tolgacatak17/PinballMachine/figures/Mechanical Design/Bumper.png

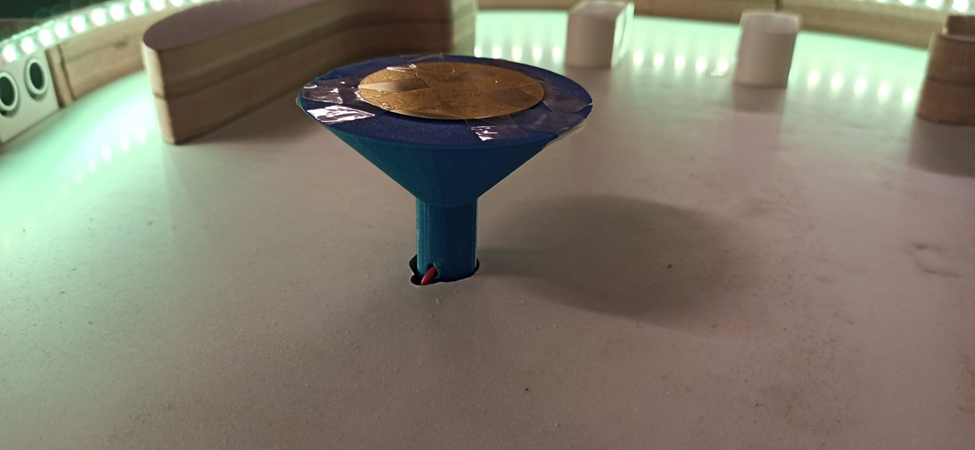
figures/Mechanical Design/Bumper.png
