tolgacatak17/PinballMachine/figures/Mechanical Design/Spinner CAD.png

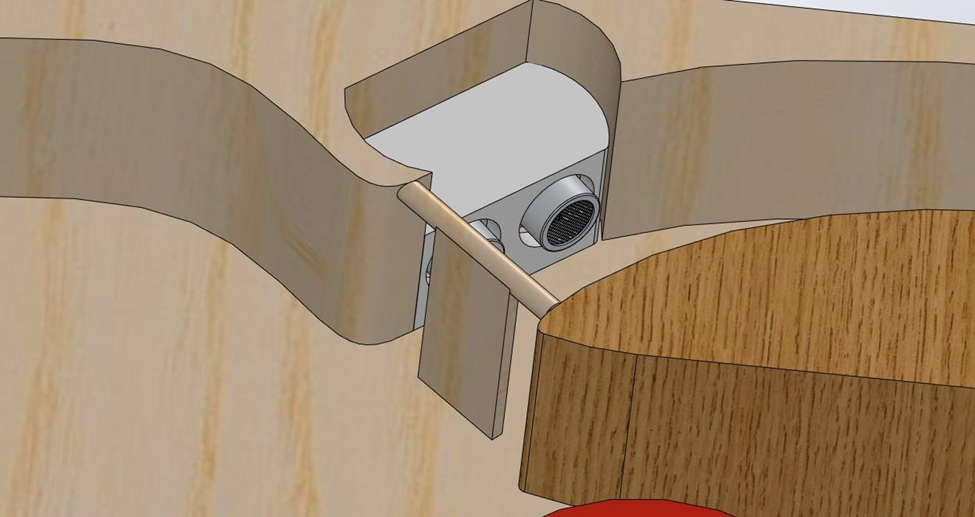
figures/Mechanical Design/Spinner CAD.png
