tolgacatak17/PinballMachine/figures/Electrical Design/Bumper Circuit Diagram.png

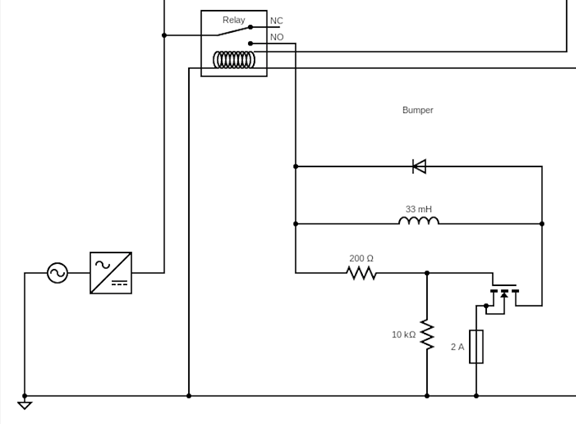
figures/Electrical Design/Bumper Circuit Diagram.png
