tolgacatak17/PinballMachine/figures/Electrical Design/In-Game Pusher Sensor.png

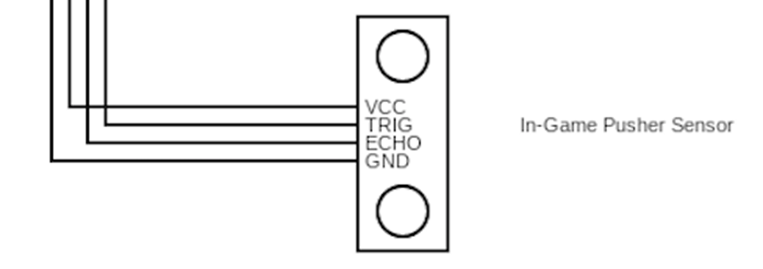
figures/Electrical Design/In-Game Pusher Sensor.png
