tolgacatak17/PinballMachine/figures/Electrical Design/In-Game Shooter Circuit Diagram.png

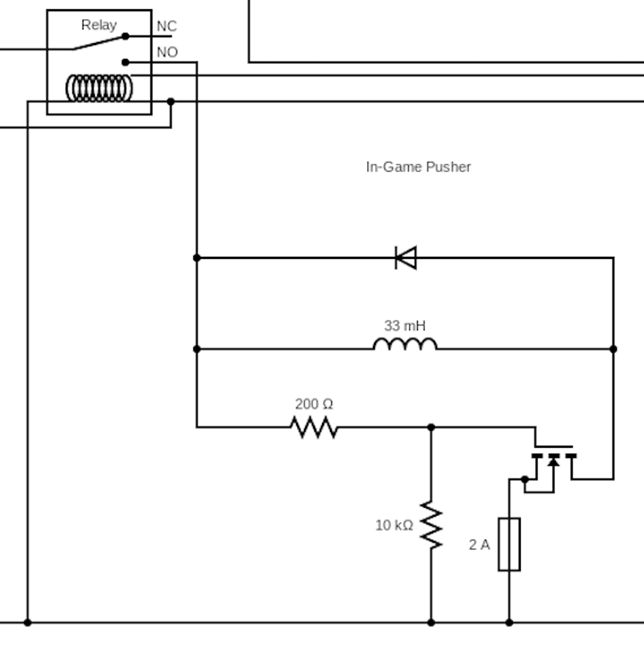
figures/Electrical Design/In-Game Shooter Circuit Diagram.png
