tolgacatak17/PinballMachine/figures/Electrical Design/Life Counting Sensor Diagram.png

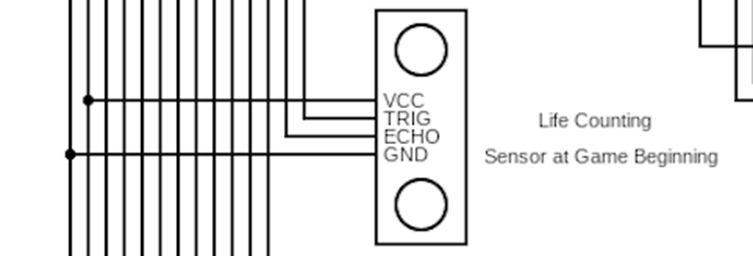
figures/Electrical Design/Life Counting Sensor Diagram.png
