tolgacatak17/PinballMachine/figures/Electrical Design/Piezo Sensor Circuit Diagram.png

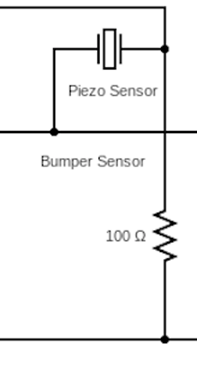
figures/Electrical Design/Piezo Sensor Circuit Diagram.png
