tolgacatak17/PinballMachine/figures/Electrical Design/RGB LEDs Circuit Diagram.png

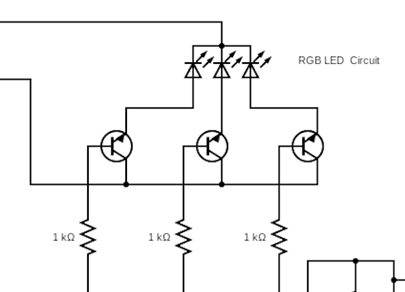
figures/Electrical Design/RGB LEDs Circuit Diagram.png
