tolgacatak17/PinballMachine/figures/Electrical Design/Spinner Circuit Diagram.png

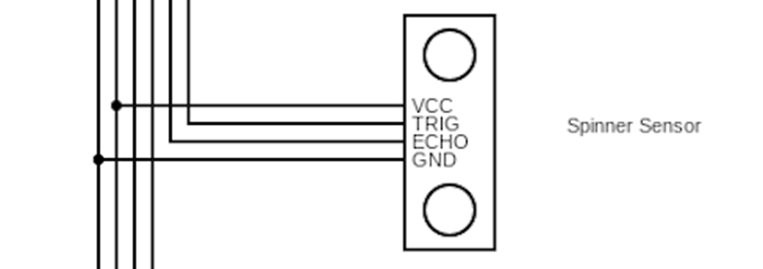
figures/Electrical Design/Spinner Circuit Diagram.png
