tolgacatak17/PinballMachine/figures/Market Analysis.png

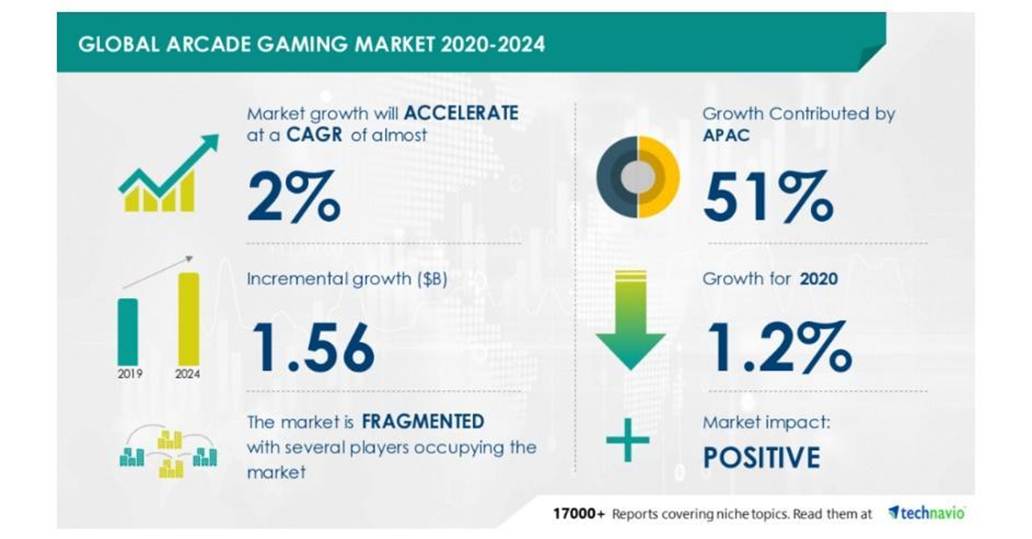
figures/Market Analysis.png
