tolgacatak17/PinballMachine/figures/Mechanical Design/Bumper CAD.png

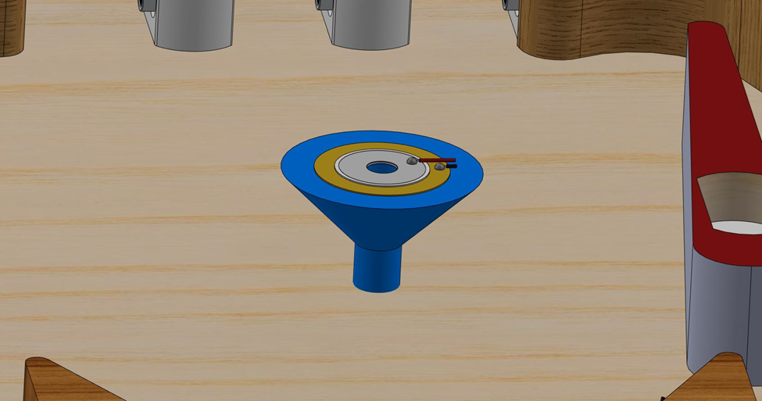
figures/Mechanical Design/Bumper CAD.png
