tolgacatak17/PinballMachine/figures/Mechanical Design/In-Game Shooter CAD.png

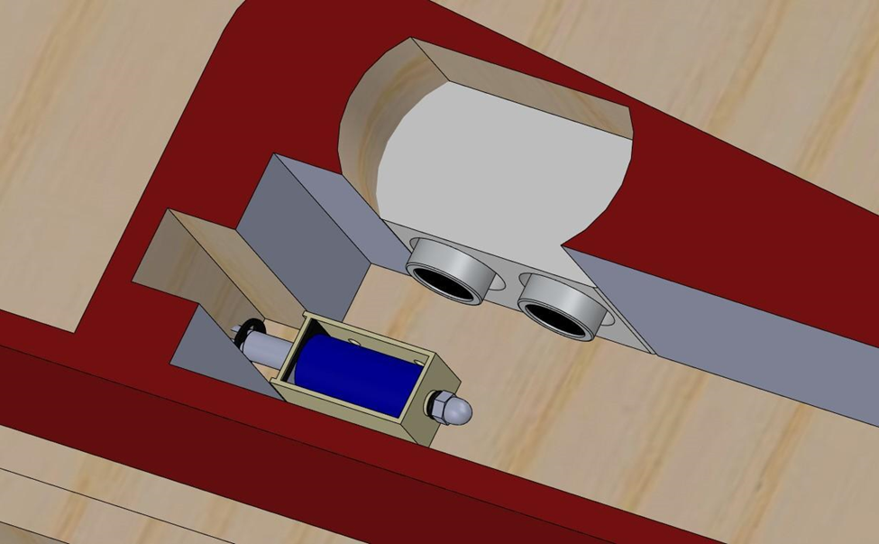
figures/Mechanical Design/In-Game Shooter CAD.png
