tolgacatak17/PinballMachine/figures/Mechanical Design/In-Game Shooter.png

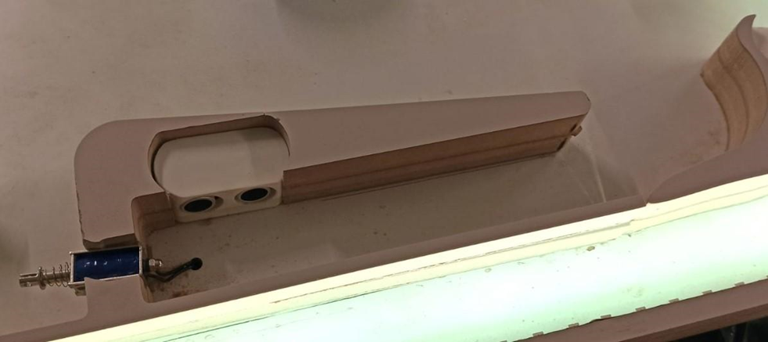
figures/Mechanical Design/In-Game Shooter.png
