tolgacatak17/PinballMachine/figures/Mechanical Design/LCD Screen.png

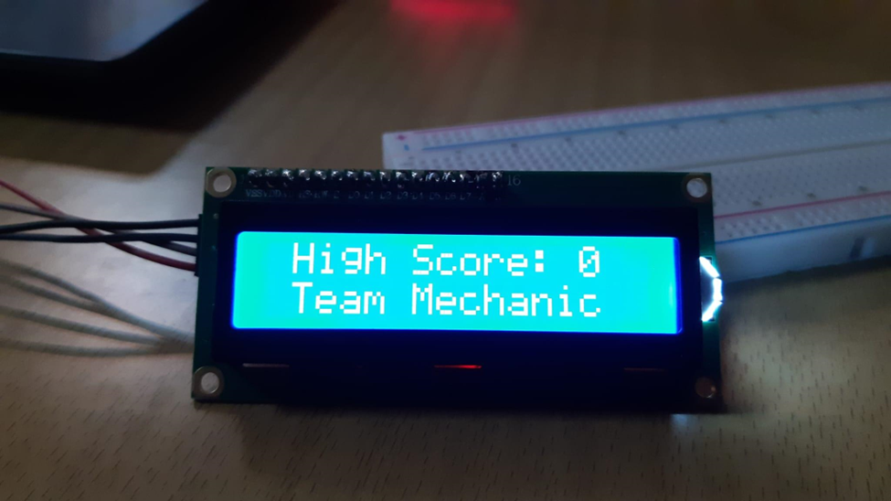
figures/Mechanical Design/LCD Screen.png
