tolgacatak17/PinballMachine/figures/Mechanical Design/Mechanism for the Bumper with Selonoid.png

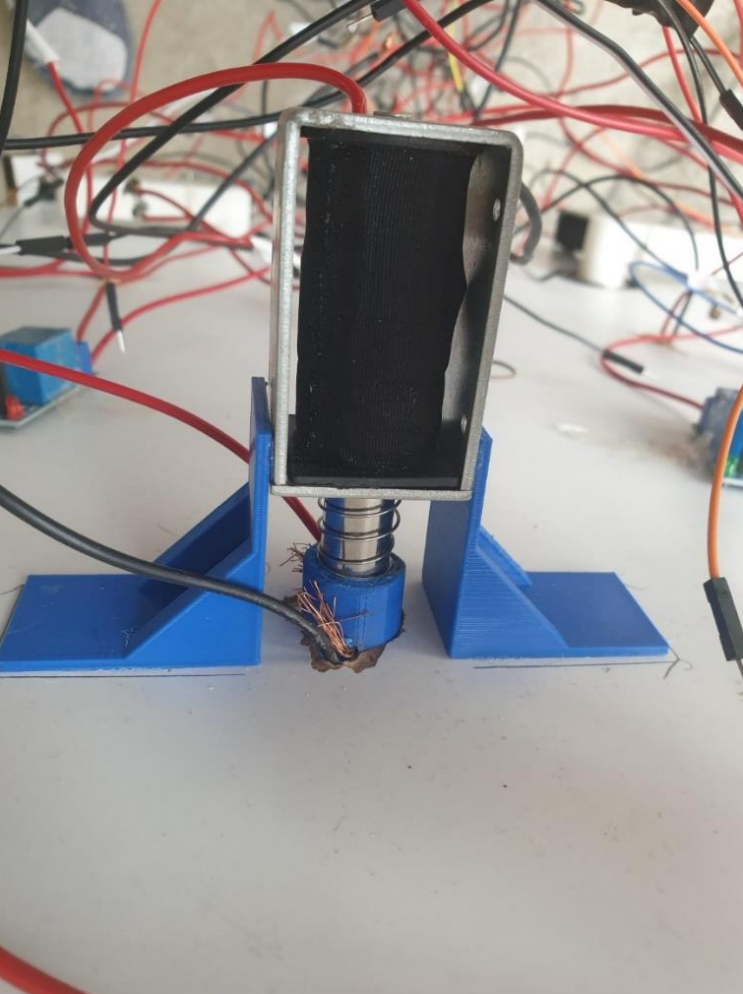
figures/Mechanical Design/Mechanism for the Bumper with Selonoid.png
