tolgacatak17/PinballMachine/figures/Mechanical Design/Slingshots.png

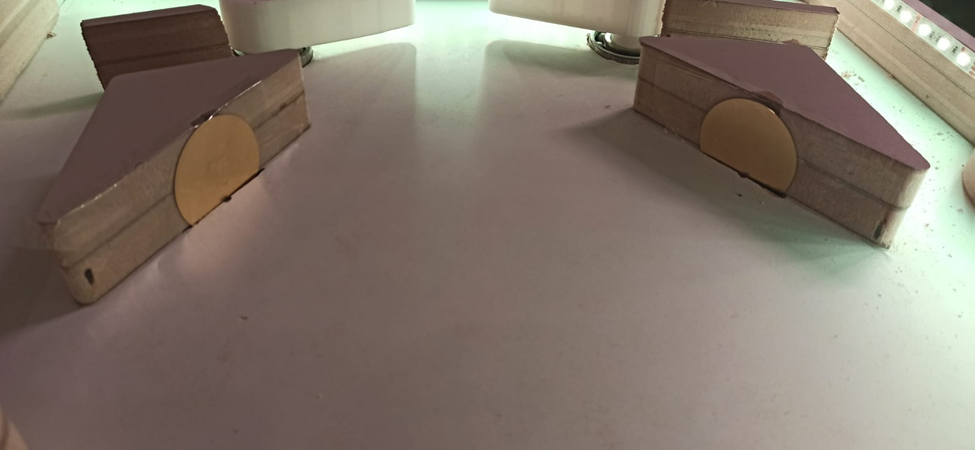
figures/Mechanical Design/Slingshots.png
