tolgacatak17/PinballMachine/figures/Mechanical Design/Ultrasonic Sensor Housings CAD.png

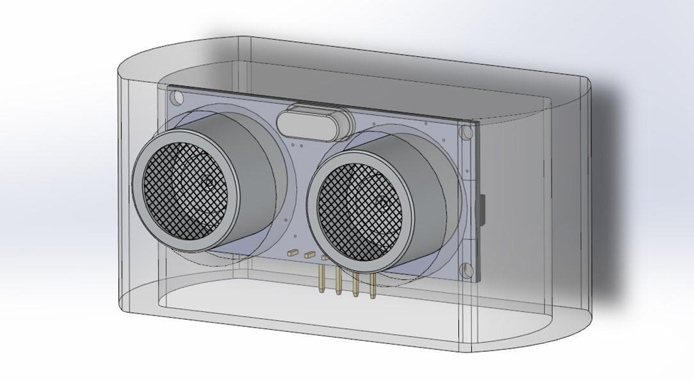
figures/Mechanical Design/Ultrasonic Sensor Housings CAD.png
