tolgacatak17/PinballMachine/figures/Pinball Machine Overview.png

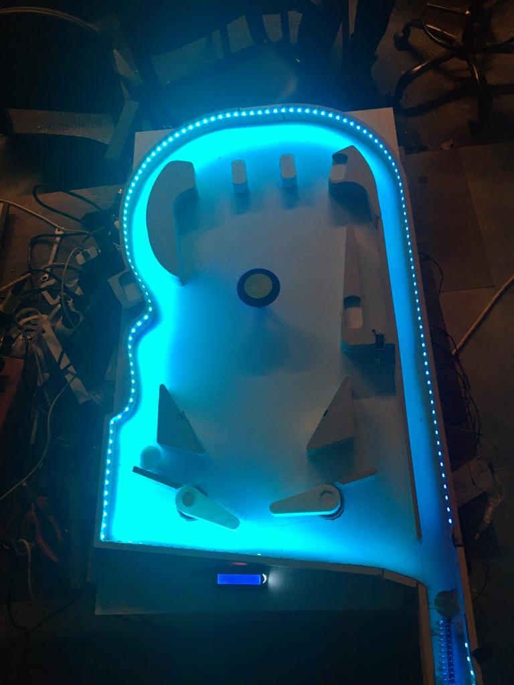
figures/Pinball Machine Overview.png
