tolgacatak17/PinballMachine/figures/Word Distribution Table.png

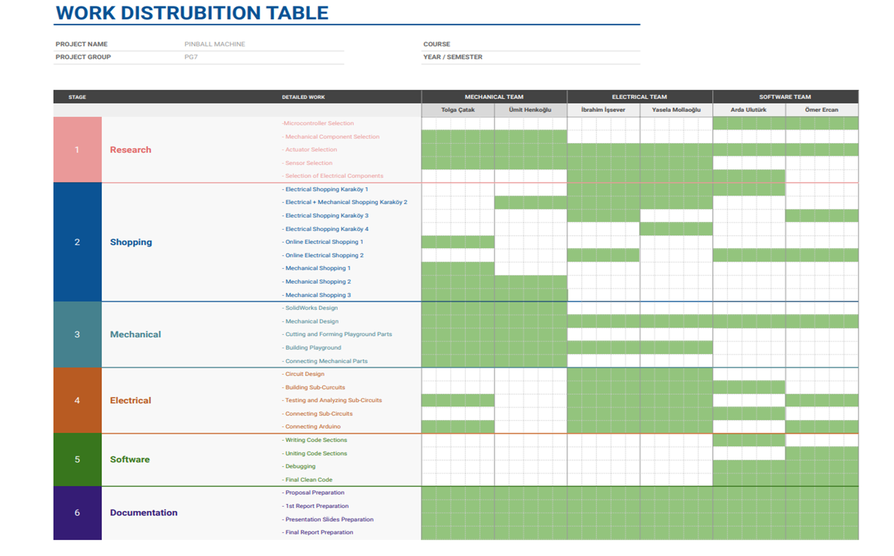
figures/Word Distribution Table.png
