tolgacatak17/PinballMachine/figures/Work in Progress.png

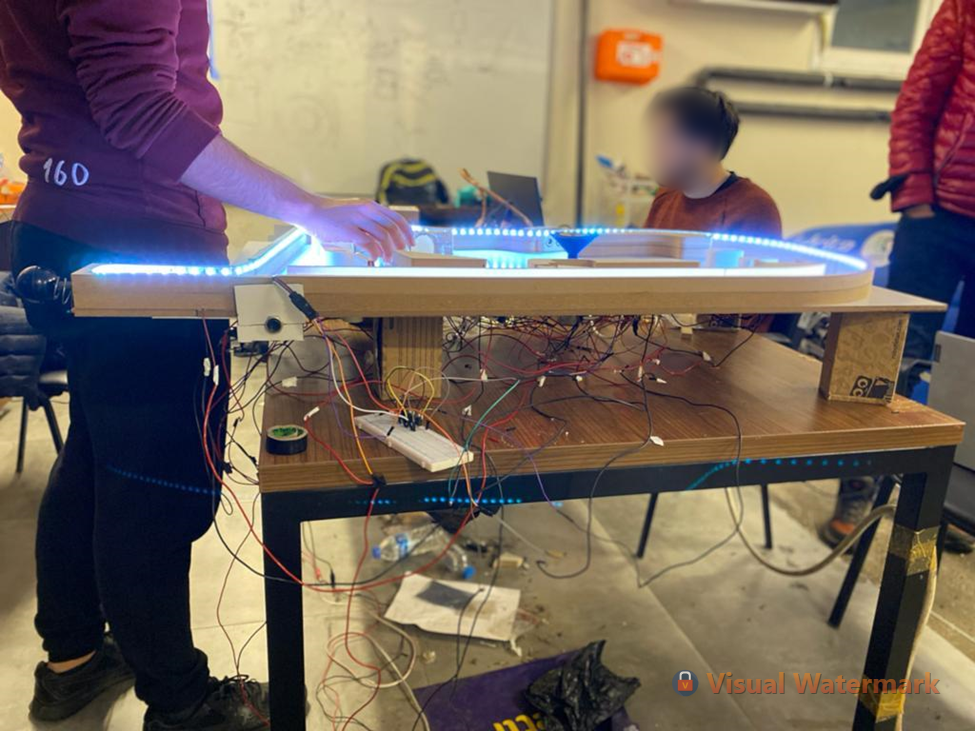
figures/Work in Progress.png
